alepape1/Aquantia_firmware/wiki/Home.md

# Bienvenido a la Wiki de Aquantia Firmware

Esta wiki documenta el firmware del sistema Aquantia para ESP32.

## Secciones principales
- [Instalación](Instalacion)
- [Uso](Uso)
- [Sensores soportados](Sensores)
- [Arquitectura del código fuente](Arquitectura)
- [TLS / Certificados MQTT](TLS)
- [Solución de problemas](FAQ)
- [Referencias técnicas](Referencias)
