alepape1/Aquantia_firmware/wiki/Referencias.md

# Referencias técnicas

- [Pinout completo](../PINOUT)
- [CHANGELOG](../CHANGELOG)
- [TLS / Certificados MQTT](TLS)
- [Documentación oficial ESP32](https://docs.espressif.com/)
- [SSLClient (OPEnSLab-OSU)](https://github.com/OPEnSLab-OSU/SSLClient)
- [Let's Encrypt — ISRG Root X1](https://letsencrypt.org/certs/isrgrootx1.pem)
