alepape1/Aquantia_firmware/tools/devices_qr/AQ-68FE710CF458.png

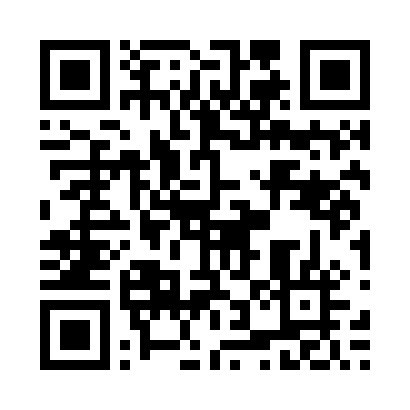
tools/devices_qr/AQ-68FE710CF458.png
