alepape1/Aquantia_firmware/tools/devices_qr/AQ-68FE719DC6CC.png

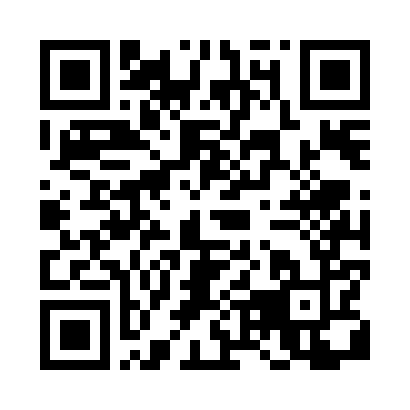
tools/devices_qr/AQ-68FE719DC6CC.png
