alepape1/Aquantia_firmware/tools/devices_qr/AQ-D8BC38FB7AC0.png

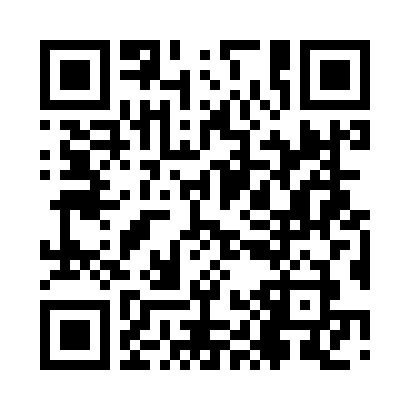
tools/devices_qr/AQ-D8BC38FB7AC0.png
