alepape1/Aquantia_firmware/ESP_monitor_server/provisioning.h

/*
 * provisioning.h — SoftAP captive portal + NVS para Aquantia (solo ESP32)
 *
 * Flujo de arranque:
 *   1. setup() comprueba si GPIO0 lleva >3s pulsado → factory reset NVS
 *   2. provisioning_load() carga credenciales desde NVS
 *   3. Si faltan credenciales → provisioning_start_ap() (bloquea hasta guardar)
 *   4. provisioning_start_ap() guarda en NVS y llama ESP.restart()
 *
 * Buffers globales rellenados por provisioning_load():
 *   prov_ssid, prov_password, prov_finca_id, prov_mqtt_token
 */
#pragma once

#ifndef ESP8266  // todo este archivo es solo ESP32

// PROFILE_AQUA_SMART_REMOTE usa TinyGSM (sin WiFi): no incluir WiFi.h
// para evitar que el driver WiFi inicialice señales internas del modem (GPIO 85)
#if DEVICE_PROFILE != PROFILE_AQUA_SMART_REMOTE
#include <WiFi.h>
#endif
#include <esp_mac.h>

#ifndef DEV_MODE
#include <Preferences.h>
// WebServer + DNSServer solo para perfiles WiFi — AQUA_SMART_REMOTE usa cellular
#if DEVICE_PROFILE != PROFILE_AQUA_SMART_REMOTE
#include <WebServer.h>
#include <DNSServer.h>
#endif

// ── Buffers globales de credenciales ─────────────────────────────────────────
char prov_ssid[64]       = "";
char prov_password[64]   = "";
char prov_mqtt_token[72] = "";  // token pre-flasheado en fábrica por Flash Tool

// Callback opcional para mostrar la pantalla AP en dispositivos con TFT.
// El .ino registra la función tras inicializar la pantalla.
static void (*_prov_ap_display_fn)(const char* ap_ssid, const char* serial) = nullptr;
inline void provisioning_register_ap_display(void (*fn)(const char*, const char*)) {
  _prov_ap_display_fn = fn;
}
#else
inline void provisioning_register_ap_display(void (*fn)(const char*, const char*)) {
  (void)fn;
}
#endif

#define FACTORY_RESET_PIN 0   // GPIO0 — botón BOOT en casi todos los ESP32

// ── Serial del dispositivo ────────────────────────────────────────────────────
// Formato: AQ-{MAC 12 hex}  ej: AQ-FCB467F37748
// Vinculado al hardware: MAC grabada en eFuse.
// Se usa como identidad del dispositivo en el QR de la etiqueta y en MQTT.

static char _device_serial[48] = "";

const char* device_serial_get() {
  if (_device_serial[0] != '\0') return _device_serial;
  // esp_read_mac lee directo de eFuse — no requiere WiFi inicializado
  uint8_t mac[6];
  esp_read_mac(mac, ESP_MAC_WIFI_STA);
  snprintf(_device_serial, sizeof(_device_serial),
           "AQ-%02X%02X%02X%02X%02X%02X",
           mac[0], mac[1], mac[2], mac[3], mac[4], mac[5]);
  return _device_serial;
}

// Devuelve la MAC WiFi STA en formato "FC:B4:67:F3:77:48".
// Usa el eFuse directamente — funciona aunque WiFi no esté inicializado.
// Usar siempre esta función (no WiFi.macAddress()) para que PROFILE_AQUA_SMART_REMOTE
// envíe el mismo identificador que los perfiles WiFi: la API lo indexa por MAC.
static String getDeviceMacAddress() {
  uint8_t mac[6];
  esp_read_mac(mac, ESP_MAC_WIFI_STA);
  char buf[18];
  snprintf(buf, sizeof(buf), "%02X:%02X:%02X:%02X:%02X:%02X",
           mac[0], mac[1], mac[2], mac[3], mac[4], mac[5]);
  return String(buf);
}

#ifndef DEV_MODE
// ── NVS ──────────────────────────────────────────────────────────────────────

static Preferences _prov_prefs;

/**
 * Carga credenciales WiFi desde NVS (espacio "aquantia").
 * Solo sobreescribe los buffers prov_* si NVS tiene valor no vacío.
 */
void provisioning_load() {
  Serial.println("[PROV] Leyendo NVS namespace 'aquantia'...");
  bool ok = _prov_prefs.begin("aquantia", /*readOnly=*/true);
  if (!ok) {
    Serial.println("[PROV] NVS namespace 'aquantia' no encontrado en modo read-only.");
    Serial.println("[PROV] Reintentando abrir NVS en modo read-write...");
    ok = _prov_prefs.begin("aquantia", /*readOnly=*/false);
    if (!ok) {
      Serial.println("[PROV] No se pudo abrir NVS 'aquantia' en modo read-write.");
      return;
    }
  }

  String s;
  if (_prov_prefs.isKey("ssid")) {
    s = _prov_prefs.getString("ssid", "");
    if (s.length() > 0) strlcpy(prov_ssid, s.c_str(), sizeof(prov_ssid));
  } else {
    Serial.println("[PROV] ssid no configurado aún");
  }

  if (_prov_prefs.isKey("password")) {
    s = _prov_prefs.getString("password", "");
    if (s.length() > 0) strlcpy(prov_password, s.c_str(), sizeof(prov_password));
  } else {
    Serial.println("[PROV] password no configurado aún");
  }

  // Token pre-flasheado en fábrica — no se escribe desde el portal
  if (_prov_prefs.isKey("mqtt_token")) {
    s = _prov_prefs.getString("mqtt_token", "");
    if (s.length() > 0) {
      strlcpy(prov_mqtt_token, s.c_str(), sizeof(prov_mqtt_token));
      Serial.printf("[PROV] mqtt_token cargado (%d bytes)\n", (int)strlen(prov_mqtt_token));
    } else {
      Serial.println("[PROV] mqtt_token vacío en NVS");
    }
  } else {
    Serial.println("[PROV] mqtt_token no encontrado en NVS");
  }
  _prov_prefs.end();
}

/** True si SSID está presente (condición mínima para conectar). */
bool provisioning_has_credentials() {
  return strlen(prov_ssid) > 0;
}

/** Guarda credenciales WiFi en NVS y actualiza los buffers globales. */
void provisioning_save(const char* ssid, const char* pass) {
  _prov_prefs.begin("aquantia", /*readOnly=*/false);
  _prov_prefs.putString("ssid",     ssid);
  _prov_prefs.putString("password", pass);
  _prov_prefs.end();
  strlcpy(prov_ssid,     ssid, sizeof(prov_ssid));
  strlcpy(prov_password, pass, sizeof(prov_password));
}

/** Borra todas las claves de provisioning del NVS. */
void provisioning_clear() {
  _prov_prefs.begin("aquantia", /*readOnly=*/false);
  _prov_prefs.clear();
  _prov_prefs.end();
  prov_ssid[0] = prov_password[0] = prov_mqtt_token[0] = '\0';
}

/** Borra solo las credenciales WiFi del NVS (mantiene mqtt_token). */
void provisioning_clear_wifi() {
  _prov_prefs.begin("aquantia", /*readOnly=*/false);
  _prov_prefs.remove("ssid");
  _prov_prefs.remove("password");
  _prov_prefs.end();
  prov_ssid[0] = prov_password[0] = '\0';
}

// ── Auto AP mode tras fallo prolongado de WiFi ────────────────────────────────
// El networkTask escribe este flag en RTC RAM antes de reiniciar.
// En el siguiente boot, setup() lo detecta y lanza el portal SoftAP sin borrar
// credenciales, permitiendo al usuario actualizarlas si cambiaron.
RTC_DATA_ATTR static uint8_t _prov_ap_forced_flag = 0;

inline void provisioning_set_ap_forced() { _prov_ap_forced_flag = 1; }

/** Devuelve true (y borra el flag) si networkTask solicitó modo AP tras fallo WiFi. */
inline bool provisioning_check_ap_forced() {
  if (_prov_ap_forced_flag) { _prov_ap_forced_flag = 0; return true; }
  return false;
}

// ── HTML del captive portal ───────────────────────────────────────────────────

static const char _PROV_HTML[] PROGMEM = R"rawliteral(
<!DOCTYPE html>
<html lang="es">
<head>
<meta charset="utf-8">
<meta name="viewport" content="width=device-width,initial-scale=1">
<title>Aquantia &mdash; Configuraci&oacute;n</title>
<style>
  *{box-sizing:border-box}
  body{font-family:system-ui,sans-serif;background:#f0f4f8;margin:0;
       padding:16px;color:#1a2a3a;min-height:100vh}
  .card{background:#fff;border-radius:16px;padding:20px;max-width:420px;
        margin:0 auto;box-shadow:0 2px 16px #0001}
  .logo{display:flex;align-items:center;gap:10px;margin-bottom:18px}
  .drop{width:36px;height:36px;background:#e8f5fd;border-radius:10px;
        display:flex;align-items:center;justify-content:center;font-size:20px;flex-shrink:0}
  h2{margin:0;font-size:1.1rem;color:#0c8ecc}
  p.sub{margin:2px 0 0;font-size:.78rem;color:#888}
  label{display:block;font-size:.72rem;font-weight:700;color:#666;
        text-transform:uppercase;letter-spacing:.06em;margin:14px 0 4px}
  input{width:100%;border:1.5px solid #dde3ea;border-radius:10px;
        padding:10px 13px;font-size:.95rem;outline:none;color:#1a2a3a;background:#fff}
  input:focus{border-color:#0c8ecc;box-shadow:0 0 0 3px #0c8ecc22}
  .hint{font-size:.72rem;color:#aaa;margin:3px 0 0}
  .save-btn{margin-top:20px;width:100%;background:#0c8ecc;color:#fff;border:none;
         border-radius:10px;padding:13px;font-size:1rem;font-weight:700;
         cursor:pointer}
  .save-btn:active{background:#0a7ab0}
  .sep{border:none;border-top:1px solid #eee;margin:16px 0}

  /* ── WiFi list ── */
  #wifi-list{display:flex;flex-direction:column;gap:6px;margin-top:6px}
  .net{display:flex;align-items:center;gap:10px;padding:9px 12px;
       border:1.5px solid #dde3ea;border-radius:10px;cursor:pointer;
       background:#fff;transition:border-color .15s,background .15s}
  .net:hover{border-color:#0c8ecc;background:#f0f8fd}
  .net.selected{border-color:#0c8ecc;background:#e8f5fd}
  .net-name{flex:1;font-size:.9rem;font-weight:600;color:#1a2a3a;
            white-space:nowrap;overflow:hidden;text-overflow:ellipsis}
  .net-lock{font-size:.75rem;color:#aaa}
  .bars{display:flex;align-items:flex-end;gap:2px;height:16px}
  .bars span{width:4px;background:#dde3ea;border-radius:2px}
  .bars span.on{background:#0c8ecc}
  .scan-btn{width:100%;padding:9px;border:1.5px dashed #dde3ea;border-radius:10px;
            background:#fff;color:#888;font-size:.85rem;cursor:pointer;margin-top:4px}
  .scan-btn:hover{border-color:#0c8ecc;color:#0c8ecc}
  .scanning{color:#0c8ecc;font-size:.82rem;text-align:center;padding:8px}

  /* ── Serial box ── */
  .serial-box{background:#f0f8fd;border:1.5px solid #b8dff7;border-radius:12px;
              padding:12px 14px;margin-bottom:16px}
  .serial-label{font-size:.7rem;font-weight:700;color:#0c8ecc;text-transform:uppercase;
                letter-spacing:.06em;display:block;margin-bottom:4px}
  .serial-val{font-family:monospace;font-size:.95rem;font-weight:700;color:#1a2a3a;
              word-break:break-all;display:block;margin-bottom:4px}
  .serial-hint{font-size:.72rem;color:#5a8aaa;margin:0}
</style>
</head>
<body>
<div class="card">
  <div class="logo">
    <div class="drop">&#128167;</div>
    <div><h2>Aquantia</h2><p class="sub">Configuraci&oacute;n del dispositivo</p></div>
  </div>

  <div class="serial-box">
    <span class="serial-label">&#128273; Serial del dispositivo</span>
    <span class="serial-val">%%SERIAL%%</span>
    <p class="serial-hint">Usa este c&oacute;digo o el QR de la etiqueta en la app para vincular el dispositivo a tu cuenta.</p>
  </div>

  <form method="POST" action="/save">
    <label>Red WiFi</label>
    <div id="wifi-list"><p class="scanning">Buscando redes...</p></div>
    <button type="button" class="scan-btn" id="scan-btn" onclick="scan()">&#8635; Buscar de nuevo</button>

    <label>SSID seleccionado</label>
    <input id="ssid-input" name="ssid" type="text" required autocomplete="off" placeholder="O escribe el nombre manualmente">

    <label>Contrase&ntilde;a WiFi</label>
    <input name="password" type="password" id="pass-input" autocomplete="off" placeholder="(vac&iacute;o si la red es abierta)">

    <button type="submit" class="save-btn">Guardar y conectar &rarr;</button>
  </form>
</div>

<script>
function bars(rssi) {
  var lvl = rssi > -55 ? 4 : rssi > -67 ? 3 : rssi > -78 ? 2 : 1;
  var h = ['4px','7px','11px','15px'];
  var s = '';
  for (var i = 0; i < 4; i++)
    s += '<span style="height:'+h[i]+'"class="'+(i<lvl?'on':'')+'"></span>';
  return '<div class="bars">'+s+'</div>';
}

function select(ssid, open) {
  document.getElementById('ssid-input').value = ssid;
  if (open) document.getElementById('pass-input').value = '';
  document.querySelectorAll('.net').forEach(function(n){n.classList.remove('selected')});
  var clicked = event.currentTarget;
  if (clicked) clicked.classList.add('selected');
}

function scan() {
  var list = document.getElementById('wifi-list');
  list.innerHTML = '<p class="scanning">&#8635; Buscando redes...</p>';
  document.getElementById('scan-btn').disabled = true;
  fetch('/scan').then(function(r){
    if(r.status===202){
      setTimeout(scan,2000);  // todavía escaneando, reintentar en 2s
      return null;
    }
    return r.json();
  }).then(function(nets){
    if(!nets) return;
    document.getElementById('scan-btn').disabled = false;
    if (!nets.length){list.innerHTML='<p class="scanning">No se encontraron redes.</p>';return;}
    list.innerHTML = nets.map(function(n){
      return '<div class="net" onclick="select(\''+n.ssid.replace(/'/g,"\\'")+'\',' +n.open+')">'
        + bars(n.rssi)
        + '<span class="net-name">'+n.ssid+'</span>'
        + '<span class="net-lock">'+(n.open?'':'&#128274;')+'</span>'
        + '</div>';
    }).join('');
  }).catch(function(){
    document.getElementById('scan-btn').disabled = false;
    list.innerHTML='<p class="scanning">Error al escanear. Escribe el SSID manualmente.</p>';
  });
}

scan();
</script>
</body>
</html>
)rawliteral";

static const char _PROV_SAVED_HTML[] PROGMEM = R"rawliteral(
<!DOCTYPE html>
<html lang="es">
<head>
<meta charset="utf-8">
<meta name="viewport" content="width=device-width,initial-scale=1">
<title>Aquantia &mdash; Listo</title>
<style>
  body{font-family:system-ui,sans-serif;background:#f0f4f8;margin:0;
       display:flex;align-items:center;justify-content:center;min-height:100vh}
  .card{background:#fff;border-radius:16px;padding:32px 28px;max-width:340px;
        text-align:center;box-shadow:0 2px 16px #0001}
  .ic{font-size:2.5rem;margin-bottom:12px}
  h2{color:#0c8ecc;margin:0 0 8px;font-size:1.2rem}
  p{color:#666;font-size:.9rem;margin:0}
</style>
</head>
<body>
<div class="card">
  <div class="ic">&#10003;</div>
  <h2>Configuraci&oacute;n guardada</h2>
  <p>El dispositivo se reiniciar&aacute; y conectar&aacute; a tu red WiFi en unos segundos.</p>
</div>
</body>
</html>
)rawliteral";

// ── SoftAP + captive portal ───────────────────────────────────────────────────

/**
 * Inicia el modo SoftAP con captive portal y espera a que el usuario
 * introduzca las credenciales. Al guardar, llama a ESP.restart().
 * Esta función NO retorna bajo operación normal.
 * En PROFILE_AQUA_SMART_REMOTE no se llama (sin WiFi — conectividad celular).
 */
#if DEVICE_PROFILE == PROFILE_AQUA_SMART_REMOTE
void provisioning_start_ap() {
  // No-op: AQUA_SMART_REMOTE usa SIM celular, no requiere portal WiFi
  DLOGLN("[PROV] provisioning_start_ap() omitido — perfil usa conectividad celular");
}
#else
void provisioning_start_ap() {
  String macStr = WiFi.macAddress();  // "AA:BB:CC:DD:EE:FF"
  char ap_ssid[32];
  snprintf(ap_ssid, sizeof(ap_ssid), "Aquantia-%c%c%c%c%c%c",
           macStr[12], macStr[13], macStr[15], macStr[16],
           macStr[18], macStr[19]);

  bool reconfigure = (prov_ssid[0] != '\0');
  Serial.printf("[PROV] %s — AP: %s\n",
                reconfigure ? "Reconectando (WiFi fallido)" : "Sin credenciales",
                ap_ssid);
  Serial.printf("[PROV] Conecta tu movil a: %s  |  Pass: aquantia1\n", ap_ssid);
  Serial.println("[PROV] Abre: http://192.168.4.1");

  // Notificar al TFT (si hay display registrado) que estamos en modo AP
  if (_prov_ap_display_fn) _prov_ap_display_fn(ap_ssid, device_serial_get());

  // WIFI_AP_STA permite escanear redes mientras el AP está activo
  WiFi.mode(WIFI_AP_STA);
  WiFi.softAP(ap_ssid, "aquantia1");
  delay(500);

  IPAddress apIP(192, 168, 4, 1);

  DNSServer  dns;
  dns.start(53, "*", apIP);

  WebServer server(80);

  server.on("/", HTTP_GET, [&server]() {
    // Inyectar el serial del dispositivo en la plantilla HTML
    String html = FPSTR(_PROV_HTML);
    html.replace("%%SERIAL%%", device_serial_get());
    server.send(200, "text/html; charset=utf-8", html);
  });

  String cachedScanJson = "[]";
  unsigned long lastScanStartMs = 0;
  auto startAsyncScan = [&lastScanStartMs]() {
    unsigned long now = millis();
    if (lastScanStartMs == 0 || now - lastScanStartMs >= 5000) {
      WiFi.scanDelete();
      WiFi.scanNetworks(/*async=*/true, /*show_hidden=*/false);
      lastScanStartMs = now;
    }
  };

  // Lanzar scan asíncrono al arrancar el portal (no bloquea)
  startAsyncScan();

  // Escaneo WiFi — devuelve JSON cuando el scan asíncrono ha terminado
  server.on("/scan", HTTP_GET, [&server, &cachedScanJson, &startAsyncScan]() {
    int n = WiFi.scanComplete();
    if (n == WIFI_SCAN_RUNNING) {
      // Todavía escaneando — el cliente reintentará
      server.send(202, "application/json", cachedScanJson);
      return;
    }
    if (n < 0) {
      // Error o no iniciado — lanzar nuevo scan asíncrono y devolver caché
      startAsyncScan();
      server.send(202, "application/json", cachedScanJson);
      return;
    }
    String json = "[";
    for (int i = 0; i < n; i++) {
      if (WiFi.SSID(i).isEmpty()) continue;
      if (json.length() > 1) json += ",";
      String ssid = WiFi.SSID(i);
      ssid.replace("\\", "\\\\");
      ssid.replace("\"", "\\\"");
      json += "{\"ssid\":\"" + ssid + "\","
              "\"rssi\":"   + WiFi.RSSI(i) + ","
              "\"open\":"   + (WiFi.encryptionType(i) == WIFI_AUTH_OPEN ? "true" : "false") + "}";
    }
    json += "]";
    cachedScanJson = json;
    WiFi.scanDelete();
    server.send(200, "application/json", cachedScanJson);
    Serial.printf("[PROV] Scan: %d redes\n", n);
  });

  server.on("/save", HTTP_POST, [&server]() {
    String ssid = server.arg("ssid");
    String pass = server.arg("password");

    if (ssid.isEmpty()) {
      server.send(400, "text/plain", "Falta el SSID de la red WiFi");
      return;
    }

    provisioning_save(ssid.c_str(), pass.c_str());
    server.send_P(200, "text/html; charset=utf-8", _PROV_SAVED_HTML);
    Serial.printf("[PROV] Guardado: ssid=%s serial=%s\n",
                  ssid.c_str(), device_serial_get());
    delay(2000);
    ESP.restart();
  });

  // Redireccionar todo al portal (captive portal iOS/Android)
  server.onNotFound([&server]() {
    server.sendHeader("Location", "http://192.168.4.1", true);
    server.send(302, "text/plain", "");
  });

  server.begin();
  Serial.println("[PROV] Portal activo en http://192.168.4.1");
  Serial.println("[PROV] Esperando configuracion del usuario...");

  for (;;) {
    dns.processNextRequest();
    server.handleClient();
    delay(10);
    yield();
  }
}
#endif  // DEVICE_PROFILE != PROFILE_AQUA_SMART_REMOTE

// ── Factory reset por pulsación larga de GPIO0 ───────────────────────────────

/**
 * Llamar al inicio de setup() (antes de Wire.begin).
 * Si GPIO0 (botón BOOT) se mantiene pulsado ≥3s, borra NVS y reinicia.
 * La duración evita resets accidentales durante el arranque normal.
 */
void provisioning_check_factory_reset() {
  pinMode(FACTORY_RESET_PIN, INPUT_PULLUP);
  if (digitalRead(FACTORY_RESET_PIN) != LOW) return;  // no pulsado

  Serial.print("[PROV] GPIO0 pulsado — manteniendo para factory reset");
  unsigned long t0 = millis();
  while (digitalRead(FACTORY_RESET_PIN) == LOW) {
    delay(100);
    Serial.print(".");
    if (millis() - t0 >= 3000) {
      Serial.println("\n[PROV] FACTORY RESET — borrando NVS...");
      provisioning_clear();
      Serial.println("[PROV] NVS borrado. Reiniciando en modo provisioning...");
      delay(300);
      ESP.restart();
    }
  }
  Serial.println(" (< 3s — cancelado)");
}

#endif  // !DEV_MODE

#endif  // !ESP8266
