alepape1/Aquantia_firmware/ESP_monitor_server/mqtt_cert.h

// mqtt_cert.h — bundle CA para TLS contra meteo.aquantialab.com
// Incluye la intermedia R13 y la raiz ISRG Root X1 de Let's Encrypt.
// Certs descargados de la cadena real del broker (meteo.aquantialab.com:8883)
// y del repositorio oficial de Let's Encrypt (isrgrootx1.pem).
//
// ISRG Root X1 SHA-256: 96:BC:EC:06:26:49:76:F3:74:60:77:9A:CF:28:C5:A7:
//                       CF:E8:A3:C0:AA:E1:1A:8F:FC:EE:05:C0:BD:DF:08:C6
//
// Path WiFi (prepareSecureClient): setCACert(MQTT_CA_CERT_PEM)
// Path SIM (SSLClient): trust_anchors.h  -- este archivo NO se usa para SIM.

#pragma once

static const char MQTT_CA_CERT_PEM[] = R"CERT(-----BEGIN CERTIFICATE-----
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
-----END CERTIFICATE-----
-----BEGIN CERTIFICATE-----
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
-----END CERTIFICATE-----
)CERT";
