alepape1/Aquantia_firmware/ESP_monitor_server/trust_anchors.h

// trust_anchors.h — generado automáticamente con gen_trust_anchor.py
// NO editar a mano. Regenerar si el cert CA cambia.
// Compatible con SSLClient (OPEnSLab-OSU/SSLClient, BearSSL).
#pragma once
#include "bearssl.h"

// ── Trust anchor 0: CN=ISRG Root X1,O=Internet Security Research Group,C=US
static const unsigned char TA0_DN[] = {
  0x30, 0x4f, 0x31, 0x0b, 0x30, 0x09, 0x06, 0x03, 0x55, 0x04, 0x06, 0x13,
  0x02, 0x55, 0x53, 0x31, 0x29, 0x30, 0x27, 0x06, 0x03, 0x55, 0x04,
  0x0a, 0x13, 0x20, 0x49, 0x6e, 0x74, 0x65, 0x72, 0x6e, 0x65, 0x74,
  0x20, 0x53, 0x65, 0x63, 0x75, 0x72, 0x69, 0x74, 0x79, 0x20, 0x52,
  0x65, 0x73, 0x65, 0x61, 0x72, 0x63, 0x68, 0x20, 0x47, 0x72, 0x6f,
  0x75, 0x70, 0x31, 0x15, 0x30, 0x13, 0x06, 0x03, 0x55, 0x04, 0x03,
  0x13, 0x0c, 0x49, 0x53, 0x52, 0x47, 0x20, 0x52, 0x6f, 0x6f, 0x74,
  0x20, 0x58, 0x31
};

static const unsigned char TA0_RSA_N[] = {
  0xad, 0xe8, 0x24, 0x73, 0xf4, 0x14, 0x37, 0xf3, 0x9b, 0x9e, 0x2b, 0x57,
  0x28, 0x1c, 0x87, 0xbe, 0xdc, 0xb7, 0xdf, 0x38, 0x90, 0x8c, 0x6e,
  0x3c, 0xe6, 0x57, 0xa0, 0x78, 0xf7, 0x75, 0xc2, 0xa2, 0xfe, 0xf5,
  0x6a, 0x6e, 0xf6, 0x00, 0x4f, 0x28, 0xdb, 0xde, 0x68, 0x86, 0x6c,
  0x44, 0x93, 0xb6, 0xb1, 0x63, 0xfd, 0x14, 0x12, 0x6b, 0xbf, 0x1f,
  0xd2, 0xea, 0x31, 0x9b, 0x21, 0x7e, 0xd1, 0x33, 0x3c, 0xba, 0x48,
  0xf5, 0xdd, 0x79, 0xdf, 0xb3, 0xb8, 0xff, 0x12, 0xf1, 0x21, 0x9a,
  0x4b, 0xc1, 0x8a, 0x86, 0x71, 0x69, 0x4a, 0x66, 0x66, 0x6c, 0x8f,
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
  BR_X509_TA_CA, \
  { \
    BR_KEYTYPE_RSA, \
    { .rsa = { \
      (unsigned char *)TA0_RSA_N, sizeof TA0_RSA_N, \
      (unsigned char *)TA0_RSA_E, sizeof TA0_RSA_E, \
    } } \
  } \
}

static const br_x509_trust_anchor TAs[1] = {
  TA0,
};

#define TAs_NUM 1
