alepape1/Aquantia_firmware/(commit log)

2026-04-22 feat(pipeline): add obstruction scenario to firmware simulator
    - Add 'obstruction' case to updatePipelineSimValues(): valve open →
    pressure stays near P_static (no hydraulic drop), flow ~0
    - Accept 'obstruction' in the three scenario whitelists:
    syncPipelineScenario() JSON path, plain-body fallback, and
    mqttCallback() pipeline_config handler
    - Update pipelineScenario comment: normal | leak | burst | obstruction
    [ESP_monitor_server.ino]
2026-04-24 feat(agrometeo): add PROFILE_AGROMETEO for CJMCU-14 hardware
    - New profile 3: ESP32 + BH1750 (light) + HDC1080 (temp/humidity) + BMP280 (pressure)
    - HDC1080 inline I2C driver (no external library), guarded from HTU2x conflict at 0x40
    - BH1750 via claws/BH1750 library, replaces TSL/APDS-9930 light sensor
    - BMP280 shared with METEO profile via #if guard
    - Calculated agrometeo params in MQTT telemetry: dew_point, heat_index, abs_humidity
    - RELAY_COUNT=0 (no valves), pipeline sensor stub ready for future hardware
    - HTU2x and TSL2584 init/read blocks guarded with #if DEVICE_PROFILE != PROFILE_AGROMETEO
    - TelemetrySnapshot extended with dewPoint/heatIndex/absHum for AGROMETEO
    - Zero-length relay a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
    [ESP_monitor_server.ino]
2026-04-24 feat(agrometeo): add Qwiic Power Switch (PCA9536) for sensor bus power control
2026-04-24 fix(agrometeo): declare bmp280 and bh1750 objects for PROFILE_AGROMETEO
    [ESP_monitor_server.ino]
2026-04-24 feat(agrometeo): add device_profile field to MQTT register payload
2026-04-25 feat(agrometeo): update setup for AGROMETEO profile and add device registry entries
    [devices_registry.csv]
2026-04-26 feat(agrometeo): update I2C pin configuration for AGROMETEO profile and adjust delays for sensor readings
    [devices_registry.csv]
2026-04-26 feat(debug): gate all serial output behind DEBUG_MODE macro
    - Replace all Serial.printf/println/print with DLOGF/DLOGLN/DLOG macros
    - DLOG macros are no-ops when DEBUG_MODE is not defined (production)
    - Serial.begin(115200) kept unconditional for OTA and boot monitor
    - Flash Tool GUI: add Debug checkbox to inject -DDEBUG_MODE=1 at compile time
    - Cache invalidation when debug mode changes; debug_mode saved in build_meta.json
    [ESP_monitor_server.ino, flasher_gui.py]
2026-04-26 fix(firmware): fix self-referential DEBUG_MODE macros and reduce I2C sensor reads to telemetry interval
    - Fix DLOGF/DLOGLN/DLOG macros that were self-referential (broke compilation)
    - Move I2C sensor reads from SCREEN_MS (1s) to telemetryIntervalMs (20s default)
    for all three profiles (METEO, IRRIGATION, AGROMETEO)
    - Decouple display refresh (HAS_DISPLAY, stays at SCREEN_MS=1s using cached values)
    from sensor reads (now synced with telemetry cycle)
    - Wind ADC loop (100ms) unchanged: pure analogRead, trivially cheap, needed for
    accurate vector averaging (~200 samples per 20s cycle)
    - Add lastSensorRead global timer alongside lastScreenTime
    [ESP_monitor_server.ino]
2026-04-26 fix(firmware): force immediate first sensor read on boot
    lastSensorRead is initialized to millis()-telemetryIntervalMs at end of setup()
    so the sensor+calc block fires on the first loop() iteration instead of waiting
    20s. Previously agroDewPoint/agroHeatIndex/agroAbsHum were NaN until the first
    telemetry cycle completed.
    [ESP_monitor_server.ino]
2026-04-26 feat(firmware): add non-blocking LED status indicator for all profiles
    LED pin per hardware profile (all active-LOW):
    METEO - LilyGo TTGO T-Display : GPIO 2
    AGROMETEO - Wemos D1 Mini ESP32 : GPIO 2
    IRRIGATION - ESP32 4-Relay Board : GPIO 23
    LED state patterns (non-blocking via ledTick() in loop()):
    LED_WIFI_CONNECTING - fast blink 100/100ms -> searching WiFi
    LED_MQTT_CONNECTING - double-blink every ~2s -> WiFi OK, MQTT pending
    LED_IDLE - heartbeat 50ms/2950ms -> connected, waiting
    LED_TX_OK - triple blink (one-shot) -> telemetry sent OK
    LED_TX_ERROR - 1s ON / 1s OFF -> network error
    LED_RELAY_ON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
    [ESP_monitor_server.ino]
2026-04-26 feat(led): add LED_PROVISIONING state for SoftAP captive portal
    Triple slow-blink (300/300 ms x3, 1.8 s pause) while the device waits
    for the user to configure WiFi via the Aquantia portal. Distinct from
    LED_WIFI_CONNECTING (fast 100 ms blink) so the board is visually
    identifiable in factory / first-boot provisioning mode.
    - New LED_PROVISIONING entry in LedStateCode enum (index 0)
    - All existing state indices shifted accordingly (_ledPatLen/_ledOneShot)
    - Initial _ledState set to LED_PROVISIONING instead of LED_WIFI_CONNECTING
    - setLedState(LED_PROVISIONING) called just before provisioning_start_ap()
2026-04-26 fix(led): invert LED logic to active-HIGH
    [ESP_monitor_server.ino]
2026-04-26 fix(led): disable LED for METEO (LilyGo T-Display has no onboard LED)
    - ledPin = -1 for PROFILE_METEO; ledTick() and pinMode() guarded on ledPin >= 0
    - AGROMETEO keeps GPIO 2, IRRIGATION keeps GPIO 23
    [ESP_monitor_server.ino]
2026-04-27 feat(agrometeo): simplify I2C configuration and enhance Qwiic Power Switch handling
2026-04-27 feat(agrometeo): integrate Qwiic Power Switch for enhanced sensor management
2026-04-27 feat(agrometeo): add MicroPressure sensor support and update device registry
    [devices_registry.csv]
2026-05-03 feat(flow-meter): add flow meter support with interrupt handling and update documentation
    [devices_registry.csv]
2026-05-03 feat(agrometeo): add flow meter configuration and update telemetry handling for PROFILE_METEO
2026-05-04 feat(agrometeo): enhance flow meter handling with K factor adjustments and debug logging
2026-05-04 feat(agrometeo): add pipeline view to TFT display and improve button logic for view switching
2026-05-04 feat(pipeline): add XDB401 I2C pressure sensor support
    - Inline driver for XDB401 (addr 0x6D, no external library)
    - XDB401_FS_BAR compile-time configurable (default 4 bar)
    - xdb401_ok flag; readRealPipelineSensors() returns real pressure when present
    - Without FLOW_PIN: returns true with flowLpm=0 so real pressure path is used
    - setup(): auto-switches pipelineMode to real if XDB401 detected
    - MQTT telemetry includes xdb401_ok field
2026-05-04 fix(pipeline): correct XDB401 driver to real XGZP6847D I2C protocol
    - Trigger acquisition: write reg 0x30=0x0A before reading
    - Wait 50ms conversion time
    - Read 5 bytes: 3 pressure (24-bit signed, bit23) + 2 temp (16-bit signed, bit15)
    - P_bar = (raw - 16777216 if >2^23) * FULLSCALE_KPA / 8388608 / 100
    - T_C = (raw - 65536 if >2^15) / 256
    - Replace XDB401_FS_BAR with XDB401_FULLSCALE_KPA (kPa, default 1000)
    - Auto-detect address: 0x6D primary, 0x7F fallback (some batches)
    - Force I2C to 100kHz (some units fail at 400kHz)
    - pressureSourceName() returns 'XDB401' with priority over MicroPressure/BMP280
    [ESP_monitor_server.ino]
2026-05-04 feat(pipeline): add pressure alert thresholds and XDB401 water temperature
    - Add PRESSURE_MIN/MAX_NORMAL, PRESSURE_DROP_ALERT, PRESSURE_HYDRO_TARGET/MARGIN defines
    - Capture xdb401Temperature in readRealPipelineSensors() via full xdb401_read()
    - Add xdb401_temperature field to MQTT telemetry payload (only when valid)
    - TFT pipeline view: show water temperature (Taq) in bottom strip when XDB401 active
    - Fix takeSnapshot() fallback (no-mutex) to capture xdb401Temperature for all profiles
    [ESP_monitor_server.ino]
2026-05-04 docs(readme): sync with feature/xdb401-pressure and feature/agrometeo-profile
    - Add PROFILE_AGROMETEO to device profiles table (CJMCU-14 / Wemos D1 Mini ESP32)
    - Update libraries table: add BH1750, Adafruit BMP280, Qwiic Power Switch for AGROMETEO
    - Update MQTT telemetry payload: all new fields (pipeline, XDB401, AGROMETEO derived,
    bmp280, temperature_source, pressure_source, relay_count, firmware_version, ts)
    - TFT section: split into Vista Meteo / Vista Pipeline with ASCII mockup and Taq display
    - Rewrite debug mode section: flag from Flash Tool GUI, not 'rama test'
    - Add new sections: XDB401 sensor (connection, config, firmware behaviour), pressure thresholds
    - Update simulated sensors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
2026-05-04 fix(xdb401): move Xdb401Reading struct before #ifndef ESP8266 to avoid Arduino forward-decl error
    [ESP_monitor_server.ino]
2026-05-04 fix(xdb401): replace struct return type with bool+output params to fix Arduino forward-decl error
    [ESP_monitor_server.ino]
2026-05-04 debug(xdb401): add diagnostic logging to xdb401_read() to trace I2C failure
    [ESP_monitor_server.ino]
2026-05-04 fix(xdb401): force 100kHz before each read, recover bus on error 4, reject all-zeros frame
    [ESP_monitor_server.ino]
2026-05-04 fix(i2c): set bus-wide 100kHz in setup() so XDB401 never sees 400kHz from other sensors
    [ESP_monitor_server.ino]
2026-05-04 fix(xdb401): autodetect continuous vs triggered mode, fix temperature formula (+10C offset), increase delay to 100ms
    [ESP_monitor_server.ino]
2026-05-04 fix(xdb401): accept ACK as sensor-present in begin(), default fullscale to 400kPa (0-4 bar)
    [ESP_monitor_server.ino]
2026-05-04 fix(xdb401): use register pointer 0x06 with repeated-start before requestFrom — direct read returns reg 0x00 (always 0)
    [ESP_monitor_server.ino]
2026-05-04 fix(xdb401): split debug DLOGF to avoid Xtensa varargs double-alignment crash (LoadProhibited)
    [ESP_monitor_server.ino]
2026-05-04 feat(xdb401): replace XDB401 driver with pressure_sensor_i2c library, fix I2C trigger, and update pressure/temperature calculations
    [ESP_monitor_server.ino, pressure_sensor_i2c.cpp, pressure_sensor_i2c.h]
2026-05-04 feat(firmware): phase 1 stability — watchdog, lock-free telemetry queue, XDB401 retry
    - Add esp_task_wdt (30s) to networkTask: auto-reset on TLS hang or broker deadlock
    - Replace dataMutex snapshot (50ms block) with xQueueOverwrite/xQueuePeek:
    Core 1 builds TelemetrySnapshot and publishes non-blocking; Core 0 reads
    without waiting. dataMutex now only protects config writes and relayActive[].
    - XDB401: track consecutive failures (MAX=5), suspend 30s then retry xdb401_begin()
    instead of silently falling back to simulation forever.
    [ESP_monitor_server.ino]
2026-05-04 fix(pressure_sensor): correct I2C address, trigger protocol and fullscale
    - PRESSURE_SENSOR_I2C_ADDR: 0x6D → 0x7F (alternate lot confirmed on installed hardware)
    - PSEN_REG_TRIGGER: 0x0A → 0x30 (register 0x30 is read/write control/status)
    - PSEN_CMD_START_ACQ: 0x30 → 0x0A (correct value per datasheet)
    - PRESSURE_SENSOR_FULLSCALE: 400.0 → 1000.0 kPa (sensor is 0-1 MPa, not 0-4 bar)
    Verified with standalone diagnostic sketch against physical datasheet.
    [pressure_sensor_i2c.h]
2026-05-04 fix(firmware): watchdog IDF 5.x compat, I2C stop-start, parallel build
    - esp_task_wdt_init: use esp_task_wdt_config_t struct (IDF 5.x API);
    fallback to esp_task_wdt_reconfigure if TWDT already initialized
    - pressure_sensor_i2c.cpp: replace repeated-start with stop-start
    (endTransmission(true)) for compatibility with XGZP sensors that
    do not implement repeated-start correctly
    - flasher_gui.py: add --jobs cpu_count to arduino-cli build command
    for parallel compilation; rename clean button label to 'Build'
    [ESP_monitor_server.ino, flasher_gui.py, pressure_sensor_i2c.cpp]
2026-05-05 Remove unused files related to TLS and provisioning for ESP32
    [partitions.csv]
2026-05-05 feat: implement LeakDetector for automatic leak detection in irrigation system
    [ESP_monitor_server.ino, LeakDetector.h]
2026-05-05 feat: add sensor reading timings and update README for better clarity
2026-05-05 release: v0.2.0-beta.1 — AGROMETEO profile, XDB401 driver rewrite, LeakDetector, dual-core lock-free telemetry
    [ESP_monitor_server.ino]
2026-05-05 fix: race-free char[16] pipeline vars, LeakDetector confirmation window, BMP280 sampling config, LeakDetector diagnostics in telemetry
    [ESP_monitor_server.ino, LeakDetector.h]
2026-05-05 fix: resolve compile errors from char[16] pipeline migration (dataMutex scope, String assign, .c_str() on char[])
    [ESP_monitor_server.ino]
2026-05-05 fix: strlcpy pipelineScenario in syncPipelineScenario (String assign to char[])
    [ESP_monitor_server.ino]
2026-05-06 fix(pipeline): pipeline_source honesto y presiones negativas del XDB401 validas
    - Cambia sentinel de presion de -1.0f a NAN para no colisionar con lecturas reales negativas
    - Sustituye umbral >= 0.0f por !isnan() en updatePipelineValues(): presiones negativas
    reales (vacio, golpe de ariete) llegan ahora a pantalla TFT y payload MQTT
    - pipeline_source reporta 'real_flow' cuando caudalimetro es real pero presion cae al sim,
    en lugar de 'real' (bandera enganosa corregida)
    - Bump version: 0.2.0-beta.1 -> 0.2.0-beta.2
    [ESP_monitor_server.ino]
2026-05-06 feat(mqtt): alarmas MQTT por cambio de estado + fix relay activo-HIGH
    - mqttPublishAlert(): publica en aquantia/{finca_id}/alerts solo al cambiar
    el estado de la condicion (sin spam por ciclo de telemetria)
    - Alarmas: leak/burst/obstruction/pipeline_ok/sensor_failure/sensor_ok/
    low_heap/mqtt_reconnect con severidades info/warning/critical
    - fix(relay): invertir logica de activo-LOW a activo-HIGH en los 5 puntos
    del codigo (init, control periodico, control MQTT, emergency OFF, comentarios)
    [ESP_monitor_server.ino]
2026-05-07 fix: increase debug interval and display timeout; update pressure sensor handling
    [ESP_monitor_server.ino]
2026-05-07 fix: update FLOW_K_FACTOR for YF-S201 calibration
    [ESP_monitor_server.ino]
2026-05-07 feat(agrometeo): add flow meter support on GPIO17
    - Define FLOW_PIN=17 and FLOW_K_FACTOR=456 for PROFILE_AGROMETEO
    (WEMOS D1 MINI ESP32). GPIO17 has no special boot constraint and
    supports hardware interrupts.
    - Fix sentinel value in readRealPipelineSensors: replace -1.0f with
    NAN for the dt<500ms early-return path so updatePipelineValues does
    not mistake it for a valid negative pressure reading.
    - Update PINOUT.md to document AGROMETEO flow meter pin."
    [ESP_monitor_server.ino]
2026-05-08 fix: update FLOW_K_FACTOR for YF-B9 calibration for Agrometeo profile
    [ESP_monitor_server.ino]
2026-05-14 fix: increase MQTT client buffer size to improve message handling
    [ESP_monitor_server.ino]
2026-05-16 fix: optimize I2C communication for pressure sensor and enhance recovery mechanism
    [devices_registry.csv]
2026-05-16 fix: I2C bus claim/release per-transaction, display info screen, flow total, reboot reason
    - pressure_sensor_i2c: _bus_claim()/_bus_release() bajan a 50 kHz solo
    durante las transacciones del XDB401 y restauran 100 kHz al soltar;
    pressureSensor_init() ya no llama Wire.begin() (bus ya init por setup());
    pressureSensor_recover() restaura _normal_freq en vez de 50 kHz globales;
    _normal_freq tomado del parámetro freq_hz de init()
    - Wire global vuelto a 100 kHz (50 kHz solo aplica al XDB401 en sus lecturas)
    - PIPELINE_FAST_MS vuelto a 500 ms
    - Vista 3 TFT «DISPOSITIVO»: reinicio, última conexión, IP, RSSI, uptime, MAC, FW
    - Botón de vista cicla entre 3 pantallas (% 3)
    - Captura esp_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
    [ESP_monitor_server.ino, pressure_sensor_i2c.cpp]
2026-05-16 fix(i2c): remove bus_claim/release, set 50kHz globally for XDB401 reliability
    Wire.setClock() en ESP32 Arduino Core v2.x llama internamente i2cReset(),
    que reinicia el bus I2C completo. El patron _bus_claim()/_bus_release() que
    cambiaba entre 50kHz y 100kHz dos veces por lectura (cada 500ms) provocaba:
    - Reset del bus durante la adquisicion de 60ms del XDB401
    - Posible corrupcion de transacciones con MCP9808/BMP280 en curso
    - Inestabilidad general en bus con cable ~1m
    Solucion: Wire.setClock(PRESSURE_SENSOR_I2C_FREQ_HZ) = 50kHz globalmente
    en setup(). Los sensores de placa (MCP9808, BMP280...) se leen cada 20s;
    la reduccion de 100->50 kHz no tiene impacto real en rendimiento.
    pressure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
    [ESP_monitor_server.ino, pressure_sensor_i2c.cpp]
2026-05-16 feat(pipeline): separate XDB401 fast timer (200ms) from slow sensors (20s)
    - Lower PIPELINE_FAST_MS 500ms → 200ms (~5Hz physical limit with 120ms read)
    - Split lastSensorRead into lastSlowSensorRead (MCP9808/BMP280/HTU21/luz/suelo
    at telemetryIntervalMs=20s) and lastPipelineFastRead (XDB401 at 200ms)
    - Block 2 slow loop only calls updatePipelineValues() in sim mode to avoid
    double XDB401 read when both timers coincide
    - Block 2b is now fully autonomous: reads XDB401, runs LeakDetector at 5Hz,
    sets pipelineSource/pipelinePressureOk/pipelineFlowOk directly, no overlap
    with slow sensor timer
    [ESP_monitor_server.ino]
2026-05-16 feat(sensors): retry reinit + MQTT alerts for MCP9808, BMP280, MicroPressure, HTU21
    Retry reinit (every telemetryIntervalMs = 20 s):
    - BMP280: if (!bmp_ok) beginBMP280()
    - MCP9808: if (!mcp_ok) tempsensor.begin(0x19)
    - MicroPressure: if (!micropressure_ok) barometer.begin()
    - HTU2x: if (!htu_ok) htu_begin()
    MQTT sensor_failure / sensor_ok alerts on state change:
    - MCP9808 (PROFILE_METEO only)
    - BMP280 (PROFILE_METEO only)
    - MicroPressure (PROFILE_METEO only)
    - HTU2x (all profiles except AGROMETEO)
    XDB401 already had retry + alerts; now all sensors are consistent.
2026-05-16 fix(log): replace MQTT TX raw JSON dump with human-readable summary line
    [ESP_monitor_server.ino]
2026-05-16 fix(log): add sensor sources and pipeline scenario/source to TX summary
    [ESP_monitor_server.ino]
2026-05-16 feat(log): add PASS/FAIL boot assertions (relays off, uptime, sensor mode)
    [ESP_monitor_server.ino]
2026-05-16 fix(log): periodic debug report shows only variable data and anomalies
    - Remove static boot info (profile, device serial, IP, SSID, MQTT status)
    from the 10s periodic report — those only need to appear once at boot
    - Replace with compact [STATUS] line: uptime + heap + RSSI
    - Keep all sensor readings ([DATOS], [AGROCALC], [PIPE], [VIENTO], [FLOW])
    - [WARN] lines only print when something is actually wrong:
    WiFi/MQTT disconnected, any sensor in SIM mode, relay active,
    pipeline scenario != normal
    [ESP_monitor_server.ino]
2026-05-16 fix(pipeline): always read XDB401 pressure even when flow calc skipped (dt<500ms)
    Root cause: readRealPipelineSensors() skipped the XDB401 read when called
    more frequently than 500ms (flow guard). The caller then received fp=NAN
    and called updatePipelineSimValues(), alternating the displayed pressure
    between the real sensor value (~0.015 bar) and the simulated value (~3.5 bar)
    every 2-3 cycles of the 200ms fast timer.
    Fix: decouple pressure and flow reads. When dt < 500ms, skip flow
    recalculation (reuse last _flowLpm) but still read XDB401 for pressure.
    Pressure is now always real when XDB401 is available.
    [ESP_monitor_server.ino]
2026-05-16 feat(mqtt): add alerts for HDC1080 and BH1750 sensor status in Agrometeo profile
2026-05-16 feat(mqtt): add MicroPressure sensor alert for Meteo and Agrometeo profiles
2026-05-17 feat(aqualeak): rename PROFILE_AGROMETEO→AQUALEAK, add relay, improve flow precision
    - Rename PROFILE_AGROMETEO (value 3) to PROFILE_AQUALEAK throughout entire firmware.
    String literal 'device_profile' in MQTT register/telemetry now reports 'AQUALEAK'.
    Flash Tool GUI label updated. NVS value (3) unchanged — no re-provisioning needed.
    - Add relay to AQUALEAK: RELAY_COUNT=1, GPIO RELAY_PIN (GPIO26, Wemos D1 Mini ESP32).
    Same active-HIGH configuration as PROFILE_METEO. Removed dummy RELAY_PINS[1]={0}.
    - Flow precision: migrate dt timer from millis() to micros() (1000x better resolution).
    Replace noInterrupts/interrupts with portENTER_CRITICAL/EXIT_CRITICAL (_flowMux).
    Add _flowS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
    [ESP_monitor_server.ino, flasher_gui.py]
2026-05-17 refactor(firmware): split .ino into modular header files
    Extract 6 logical modules from ESP_monitor_server.ino (~3480 lines -> 2527 lines):
    - led_control.h : LED state machine (setLedState, ledTick, patterns)
    - htu2x_driver.h : HTU21D/SHT21 I2C driver
    - light_sensor.h : TSL2584/APDS-9930 autodetect driver
    - hdc1080_driver.h : HDC1080 driver + agro derived params (PROFILE_AQUALEAK)
    - display_tft.h : TFT ST7789 drawing functions (HAS_DISPLAY only)
    - mqtt_helpers.h : mqttCallback, mqttConnect, mqttPublishRegister, mqttPublishAlert
    Each header is #pragma once and included from the sketch after all globals
    are declared, maintaining Arduino single-TU compilatio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
2026-05-17 feat(display): update flow display logic and adjust layout for better readability
2026-05-17 fix(flow): update K factor for YF-B4 based on empirical calibration
    [ESP_monitor_server.ino]
2026-05-17 feat(flow): implement pulse counters for irrigation and leak detection to improve flow precision
    [ESP_monitor_server.ino]
2026-05-17 fix(flow): update K factor comment for YF-B9 calibration details
    [ESP_monitor_server.ino]
2026-05-18 feat(halisense): integrate Helissense sensor support and display soil data
2026-05-19 feat(soil-sensor): add SoilSensor class for RS485 Modbus soil sensor integration
2026-05-19 feat(halisense): add Halisense sensor header inclusion for integration
2026-05-19 feat(halisense): update Helissense sensor configuration and improve UI responsiveness
2026-05-20 Actualiza la documentación del firmware Aquantia ESP32: - Añade detalles sobre el tiempo de espera de la pantalla TFT ajustable vía MQTT en `README.md`. - Incluye nuevos campos en la telemetría y com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
    [ESP_monitor_server.ino]
2026-05-27 feat(halisense): update Helissense sensor configuration for irrigation profile and enhance WiFi power settings
2026-05-28 feat(soilSensor): streamline response timeout handling and remove debug prints
2026-05-29 feat(wiki): create initial documentation structure including Home, FAQ, Installation, Usage, Sensors, and References
2026-05-29 feat(network): enhance WiFi reconnection logic with failure count and restart mechanism
    [ESP_monitor_server.ino]
2026-05-29 feat(network): improve sensor alert logic with cooldown periods to reduce spamming
2026-05-29 feat(network): adjust WiFi transmission power to improve connectivity stability
    [ESP_monitor_server.ino]
2026-05-29 feat(network): adjust WiFi transmission power to 18.5 dBm and update sensor alert cooldown logic
2026-05-30 feat(irrigation): add AHT20 and INA219 sensor drivers for temperature, humidity, and power monitoring
2026-05-30 fix(irrigation): correct GPIO pin assignment for soil sensor in irrigation profile
    [ESP_monitor_server.ino]
2026-05-30 feat(wdt): implement WDT heartbeat logging for task monitoring and reboot reason enhancement
    [ESP_monitor_server.ino]
2026-05-30 docs: update documentation for INA219/AHT20 sensors and IRRIGATION fixes
    - Fix stale RX/TX comment in .ino after GPIO pin swap (GPIO14=RX, GPIO13=TX)
    - PINOUT.md: correct IRRIGATION RS485 table (RX=14, TX=13, DE/RE=27)
    - PINOUT.md: add AHT20 and INA219 I2C sensor table for IRRIGATION profile
    - PINOUT.md: update connection diagram to include new sensors and correct RS485 pins
    - README.md: add AHT20/INA219 to IRRIGATION profile table and sensor cycle table
    - README.md: document INA219 telemetry fields (ina219_ok, bus_voltage, current_ma, power_mw)
    - README.md: document WDT heartbeat phases and 12h sensor alert cooldown
    - README.md: document WiFi TX power (18.5 dBm) and robust reconnection logi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
    [ESP_monitor_server.ino]
2026-05-30 feat(network): increase MQTT buffer size to enhance data transmission capacity
2026-06-01 Refactor MAC address retrieval and add support for AQUA_SMART_REMOTE profile
    - Replaced direct calls to WiFi.macAddress() with a new function getDeviceMacAddress() to ensure consistent MAC address retrieval across different profiles.
    - Updated mqttCallback, mqttConnect, mqttPublishRegister, and mqttPublishAlert functions to use the new MAC address function.
    - Added a new profile (PROFILE_AQUA_SMART_REMOTE) in PINOUT.md with detailed information about the device, connectivity, and GPIO assignments.
    - Modified provisioning_start_ap() to be a no-op for the AQUA_SMART_REMOTE profile, which uses cellular connectivity instead of WiFi.
    [ESP_monitor_server.ino, mqtt_helpers.h, provisioning.h]
2026-06-01 feat: implement GSM state caching and GPRS connection improvements for AQUA_SMART_REMOTE profile
    [devices_registry.csv]
2026-06-01 feat: update TLS configuration for SIM7000G and add new device entries in registry
    [devices_registry.csv]
2026-06-01 feat: implement controlled polling for SIM7000G cellular queries to reduce TLS/MQTT interference
    [ESP_monitor_server.ino]
2026-06-01 feat: enhance SIM7000G TLS handling and connection stability with context management and socket cleanup
    [ESP_monitor_server.ino, mqtt_helpers.h]
2026-06-01 feat: enhance SIM7000G initialization and PDP recovery for improved connection stability
    [ESP_monitor_server.ino]
2026-06-01 fix(mqtt-tls): always prepare GSM TLS client before each connection attempt
    - Remove gsmTlsConfigured flag guard that prevented prepareGsmTLSClient() from being called on retries
    - Call prepareGsmTLSClient(_gsmTlsCtx) unconditionally before every TLS MQTT connect on port 8883
    - This ensures SSL context, timeout, and AT configuration are refreshed on each retry attempt
    - Fixes bug where SSLcontext was stale on retry attempts 1-2, only refreshing after 3 fails
    - Device now actively switches SSL context between ctx=0 and ctx=1 on connection failures
    - Logs show [TLS] configuration being applied on every retry, not just initial attempt
    The 32s timeout still persists, but TLS is now properly re-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
    [ESP_monitor_server.ino, mqtt_helpers.h]
2026-06-01 Harden secrets handling and add global sensor recovery backoff
2026-06-01 feat(tls): replace SIM7000G hardware SSL with BearSSL/SSLClient on ESP32
    El firmware SIM7000G R1529 no soporta AT+CSSLCFG="authmode"/"cacert",
    haciendo imposible la verificación de CA mediante el stack SSL del modem.
    Cambios:
    - TINY_GSM_MODEM_SIM7000SSL → TINY_GSM_MODEM_SIM7000 (TCP plano)
    - TinyGsmClientSecure reemplazado por SSLClient (BearSSL, mux 1)
    con TinyGsmClient como capa TCP base
    - Toda la lógica AT+CSSLCFG eliminada de prepareGsmTLSClient()
    - SNI via gsmTLSClient.setHostname(), timeout 75 s para handshake 2G/LTE-M
    - Eliminados _gsmTlsCtx, gsmTlsConfigured y rotación de ctx TLS
    Nuevos archivos:
    - trust_anchors.h: trust anchor BearSSL para ISRG Root X1 (RSA-4096)
    generado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
    [ESP_monitor_server.ino, gen_trust_anchor.py, mqtt_cert.h, trust_anchors.h]
2026-06-01 docs(tls): document dual-path TLS architecture (WiFi mbedTLS / SIM BearSSL)
    - README: expand TLS section with architecture table per profile,
    explain why BearSSL is used for SIM (R1529 AT+CSSLCFG limitation)
    - wiki/TLS.md: new page with full architecture diagrams, cert file index,
    fingerprint reference, cert renewal steps, SSLClient install guide,
    and TLS handshake diagnostics
    - wiki/Home.md: add TLS page to navigation
    - wiki/Referencias.md: add SSLClient and Let's Encrypt links
2026-06-01 fix(tls): fix three SSLClient compilation errors
    1. trust_anchors.h: add BR_KEYTYPE_RSA and inner pkey struct level.
    BearSSL's br_x509_pkey is a struct {key_type; union key{rsa,ec}},
    not a bare union — designated initializer .rsa needed one more level.
    2. ESP_monitor_server.ino: pass _gsmTCPBase by reference, not pointer.
    SSLClient(Client& ...) takes a reference; &_gsmTCPBase was a pointer.
    3. ESP_monitor_server.ino: remove setHostname() — method does not exist
    in SSLClient; SNI is set automatically in connect(host, port).
    Also fix gen_trust_anchor.py macro template to match correct struct layout.
    [ESP_monitor_server.ino, gen_trust_anchor.py, trust_anchors.h]
2026-06-01 feat(gsm): slim MQTT payload for AQUA_SMART_REMOTE, fix TAs_NUM log
    - PROFILE_AQUA_SMART_REMOTE now compiles a ~350 B slim payload instead
    of the full ~820 B payload: removes static device fields (already in
    register), diagnostics (bmp280_ok, xdb401_ok, sensor status flags),
    debug (free_heap, uptime_s), deprecated DHT11 fields, pipeline state
    strings (scenario/mode/source/irrigation_type), and leak baselines.
    Core data kept: env sensors, pipeline pressure/flow, soil NPK (if
    halisense present), INA219 power (if present), relay_active, rssi, ts.
    - Remove dht_temperature / dht_humidity from all profiles (DHT11 is
    no longer used in the project).
    - Remove temperature_barometer (was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
    [ESP_monitor_server.ino]
2026-06-01 feat: add free_heap/uptime_s to GSM slim payload and sketch size to register
    - GSM slim payload: add free_heap and uptime_s (critical for leak/reboot detection)
    - mqttPublishRegister: add sketch_size_kb and free_sketch_kb (static, sent once on boot)
    - Bump StaticJsonDocument in mqttPublishRegister from 320 to 400 to fit new fields
    [ESP_monitor_server.ino, mqtt_helpers.h]
2026-06-01 refactor: modularize ESP_monitor_server.ino into 7 header modules
    Split the 3893-line monolithic .ino into focused .h files:
    - sensor_recovery.h — BMP280 helpers, xdb401, recovery logic
    - pipeline_core.h — simulation, noise, real pipeline read/update
    - wind_sensor.h — ADC filter, wind vector accumulation
    - http_client.h — WiFi HTTP layer (non-GSM profiles)
    - gsm_modem.h — SIM7000G power-on, GPRS, TLS (AQUA_SMART_REMOTE)
    - network_task.h — takeSnapshot + full networkTask FreeRTOS task
    - sensor_read.h — readSlowSensors + readSoilSensor loop helpers
    The .ino is now 1696 lines (down from 3893). All globals remain in .ino;
    headers contain only function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
    [ESP_monitor_server.ino, gsm_modem.h, http_client.h, network_task.h, pipeline_core.h, sensor_read.h, sensor_recovery.h, wind_sensor.h]
2026-06-01 fix: remove stray lines prepended to .ino during modularization
    PowerShell Out-File/Get-Content round-trip with UTF-8 BOM caused
    3 garbage lines (}, #endif // DEBUG_MODE, }) to appear at the top
    of the file before the real header comment, breaking preprocessor
    balance. Removed the 3 stray lines and the resulting duplicate
    header comment.
    [ESP_monitor_server.ino]
2026-06-02 coold dowm sensor stop for 24 hours after oner hour reconnecting
2026-06-02 feat: per-profile FINCA_ID/hostname in flasher + mqtt_reconnect cooldown 1h
    - flasher_gui.py: write FINCA_ID and DEVICE_HOSTNAME to secrets.h based on
    selected device profile at compile time; OTA discovery resolves all profile hostnames
    - ESP_monitor_server.ino: use DEVICE_HOSTNAME macro in ArduinoOTA.setHostname()
    instead of hardcoded "meteostation-esp32"
    - network_task.h: increase mqtt_reconnect alert cooldown from 10 min to 1 h;
    routine sleep-wake reconnects no longer generate alerts
    [ESP_monitor_server.ino, flasher_gui.py, network_task.h]
2026-06-03 SoilSensor.h / SoilSensor.cpp Eliminados los comandos hardcodeados (READ_ALL_REG, etc.) → todos los comandos se construyen dinámicamente con CRC calculado en runtime Nuevo campo _slaveAddr (por defec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
2026-06-03 9600 baud rate for soil sensor changed
2026-06-08 fix(firmware): publish INA219 voltage+current, fix flow fields, soil baud 4800, pH scale
    network_task.h:
    - Add ina219_bus_voltage and ina219_current_ma to both GSM slim and full WiFi payloads
    (firmware computed them but never published — backend columns were already waiting)
    - Bump GSM StaticJsonDocument 512→640, char buf 512→640
    - Bump WiFi char buf 1024→1280 to prevent truncation after new flow+INA fields
    - Add flow_session_l, flow_irrig_l, flow_leak_l to full WiFi payload
    - Bump WiFi StaticJsonDocument 1024→1280
    halisense_sensor.h:
    - pH scale: divide by 100 instead of 10 (sensor returns ×100 values)
    SoilSensor.h / ESP_monitor_server.ino:
    - Default baud rate 9600→4800 for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
    [ESP_monitor_server.ino, SoilSensor.h, halisense_sensor.h, network_task.h, soil_baud_changer.ino]
2026-06-08 docs: update CHANGELOG and README for feat/per-profile-device-ids
    CHANGELOG: new [Unreleased — feat/per-profile-device-ids] section documenting
    INA219 missing fields fix, flow counters fix, Halisense pH scale fix,
    soil baud rate fix, and JSON buffer size increases.
    README:
    - GSM slim payload: StaticJsonDocument<512> → <640>, add ina219_bus_voltage
    and ina219_current_ma to payload example and notes
    - Helissense register table: pH scale ÷10 → ÷100
2026-06-08 soil sensor config included
2026-06-09 fix(mqtt): use persistent session to prevent lost valve commands
    cleanSession=false in mqttConnect() so the broker queues QoS 1 messages
    while the device is offline and delivers them on reconnect. Eliminates
    valve commands dropped during WiFi/MQTT reconnection cycles.
    Also documents the full relay command flow and dynamic telemetry interval
    (5 s during irrigation, 20 s at rest) in wiki and Arquitectura.
    [mqtt_helpers.h]
2026-06-10 docs(agent): update aquantia-firmware agent with current repo state and git workflow rules
    - Sync state to feat/per-profile-device-ids (commit ab3383f)
    - Add SoilProvisioner, INA219, persistent MQTT session, reconnect cooldown
    - Expand file map with *_task.h, SoilProvisioner.h, sensor_recovery.h
    - Add dual-core architecture table and sensor fallback chain
    - Add Conventional Commits rules with real examples from history
    - Add branch naming convention, flow diagram, and pre-push checklist
2026-06-10 fix(firmware): guard _flowPulseTotal ISR read with noInterrupts in debug log
    [ESP_monitor_server.ino]
2026-06-10 fix(pipeline): zero _flowLpm on flow stop, extract readXDB401Safe helper
    - Ghost flow guard: si _flowLpm > 0 pero no llegan pulsos en el intervalo actual
    y ese intervalo supera 2 periodos esperados al caudal previo, forzamos _flowLpm=0
    para reflejar la parada inmediatamente en lugar de esperar hasta 500 ms.
    - readXDB401Safe(): extrae la logica de reintentos y fallos del XDB401 que estaba
    duplicada 3 veces en readRealPipelineSensors. Sin cambio de comportamiento.
    [pipeline_core.h]
2026-06-10 docs: update CHANGELOG, README and agent for ghost-flow fix and XDB401 refactor
    - CHANGELOG: entradas Fixed + Refactored para los dos commits previos
    - README: version 0.3.0-beta, rama feat/per-profile-device-ids, 4 perfiles
    - Agent: ultimo commit actualizado, ghost-flow guard y readXDB401Safe en avances recientes
2026-06-10 docs(wiki): update all wiki pages to reflect current firmware state
    - Arquitectura: agrega SoilProvisioner.h al arbol, documenta readXDB401Safe
    y ghost flow guard en pipeline_core.h, corrige buffer sizes 1024->1280 / 512->640
    - Sensores: reescritura completa — tabla por perfil, cadena de fallback, seccion
    XDB401 (sentinel NAN, readXDB401Safe), INA219 campos, Helissense pH x100
    - Instalacion: de stub a guia completa con arduino-cli por perfil, flasher_gui,
    factory_provision, provisioning SoftAP y monitor serie
    - FAQ: agrega seleccion de perfil, sensor suelo (SoilProvisioner), ghost flow,
    reset a fabrica; convierte lista plana en secciones con anclas
    - Uso: agrega seccion SoilProvisi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
2026-06-19 feat(provisioning): auto AP mode after WiFi failure + MQTT update_wifi command
    Cuando el router cambia de SSID/contraseña, el dispositivo quedaba atrapado
    en un bucle reinicio → reintentos → reinicio indefinidamente sin recuperación.
    Capa 1 — Auto AP mode: tras 60 reintentos fallidos (~30 min), se activa un
    flag en RTC RAM (RTC_DATA_ATTR) y el siguiente boot abre el portal SoftAP
    sin borrar las credenciales existentes. Si el router estaba caído
    temporalmente, cerrar el portal y el dispositivo reconecta solo.
    Capa 2 — MQTT update_wifi: nuevo comando {"cmd":"update_wifi","ssid":"X",
    "password":"Y"} para actualizar credenciales en NVS remotamente mientras el
    dispositivo aún tiene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
    [ESP_monitor_server.ino, mqtt_helpers.h, network_task.h, provisioning.h]
2026-07-08 feat(sensor): add ENS160+AHT21 IAQ sensor support with runtime autodetection
    - New ens160_driver.h: pure Wire driver — detect by PART_ID (0x52/0x53),
    reset, standard mode, T/RH compensation, read AQI/TVOC/eCO2
    - AHT21 (0x38) already handled by aht20_driver.h (protocol-identical)
    - Detection runs on all profiles without recompilation; if not present,
    ens160_ok remains false and no data is published
    - Compensation fed from existing primary sensor (MCP9808/HTU2x, HDC1080,
    AHT20) — no duplicate I2C reads
    - MQTT: ens160_aqi, ens160_tvoc, ens160_eco2 added to both full WiFi
    payload and GSM slim payload (conditional on ensAqi > 0)
    - Serial boot log now prints a complete sensor summary t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
    [ESP_monitor_server.ino, ens160_driver.h, network_task.h, sensor_read.h]
2026-07-13 feat(sensor): add AHT21 support as a fallback for temperature and humidity readings
2026-07-14 feat(docs): update device profiles to include four hardware profiles and correct GPIO assignments
